JAndrassy/Regulator/img/GALLERY.MD

# Project history in images

## 2017

Kemo modules and Arduino Uno WiFi Developer Edition

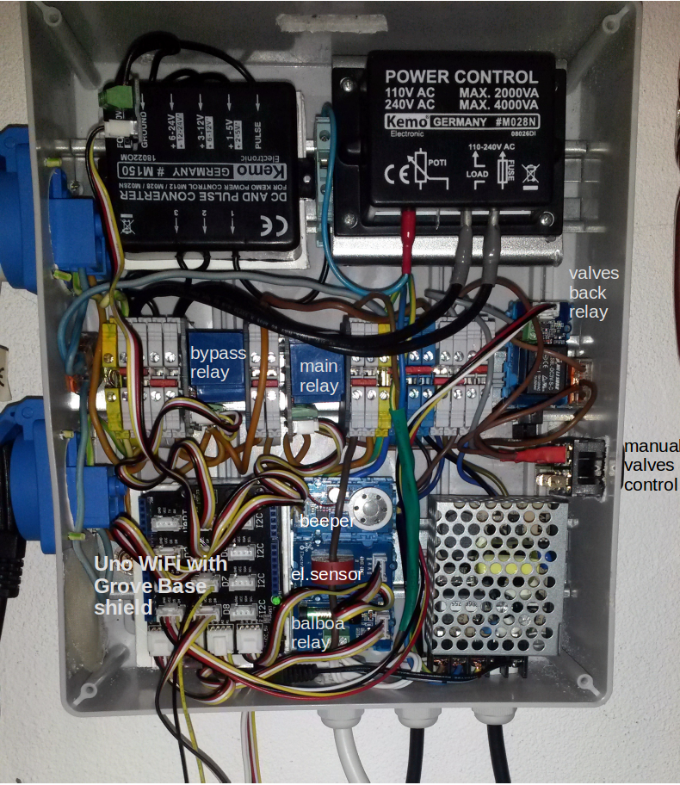
[picture p4: img/regulator-labeled.png]


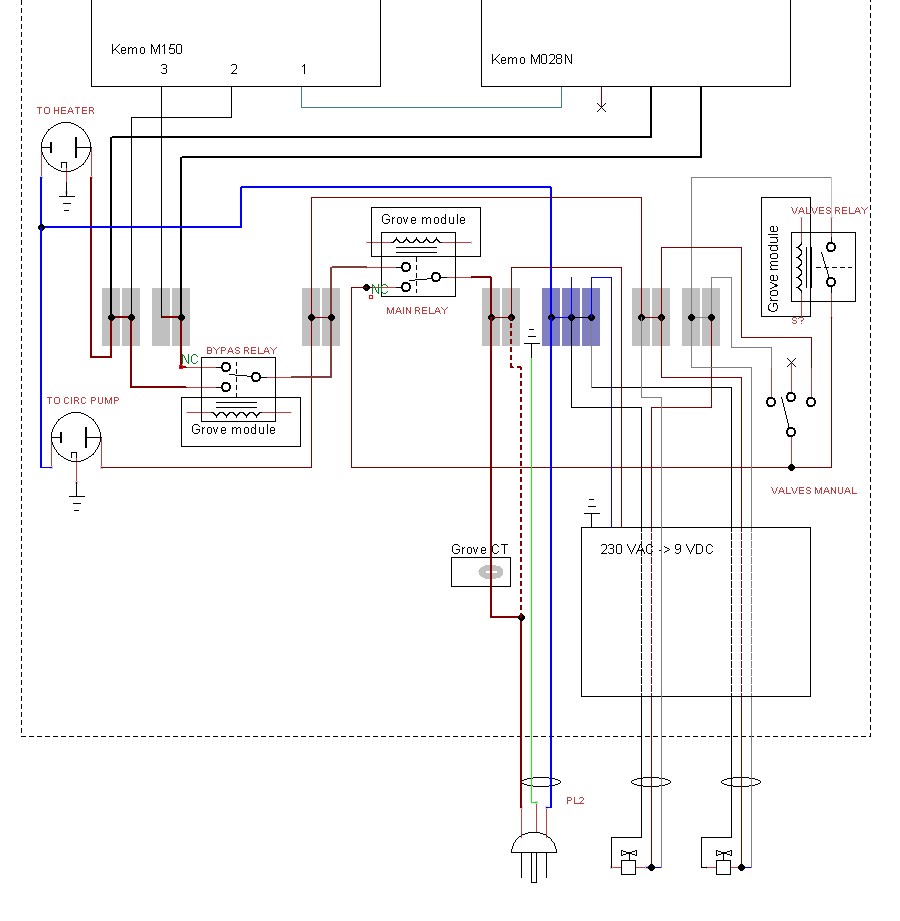
[picture p5: img/schemaAC.png]


## 2018-05

With Wemos D1 R2, MOSFET and I2C ADC module.

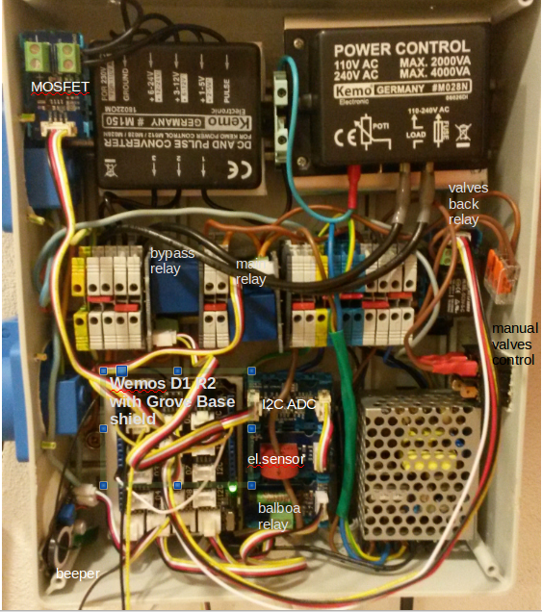
[picture p6: img/regulator-d1-labeled.png]




## 2018-09

Crowduino M0-SD with Ethernet shield and experiments with the ENC28J60 module.

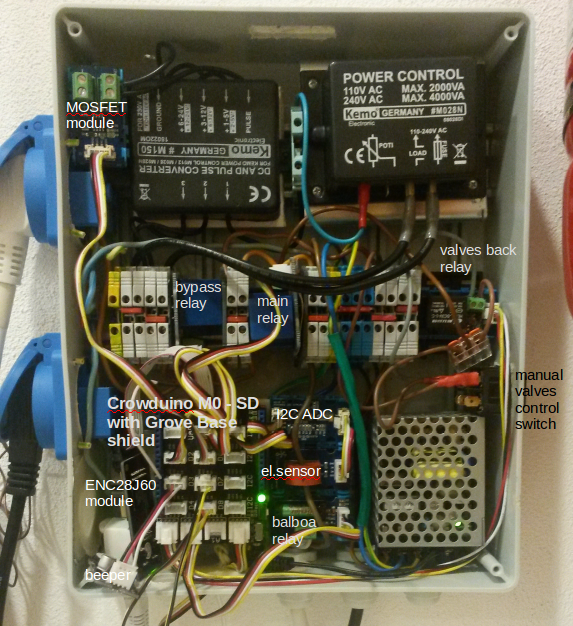
[picture p7: img/regulator-m0-labeled.png]


## 2019

Kemo modules replaced with Triac/ZC module.

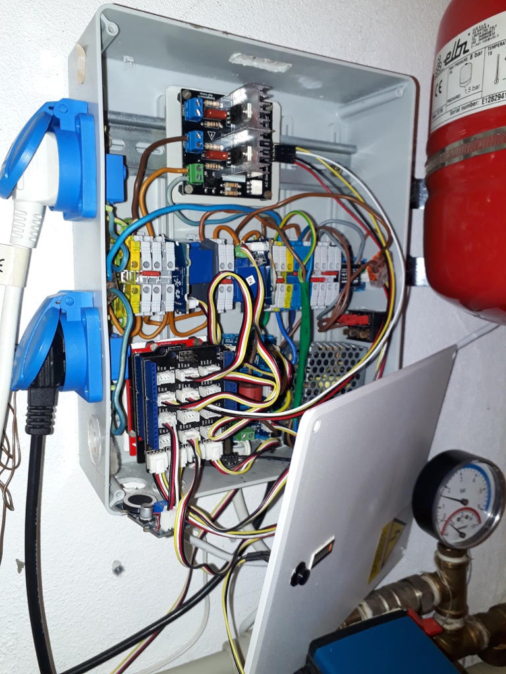
[picture p8: img/regulator-w-dimmer.jpg]


# 2020 - 2021

AVR ATmega1284p board with Ethernet Shield, CT replaced with ACS712 and the power adapter replaced.





ENC28J60 with my EthernetENC library. Circ. pump relay experiment.



# 2022

Single Triac module with a large heatsink.



End of circ. pump experiment. SSR relays.



Nano 33 IoT experiment with a temporary voltage divider on a mini breadboard.

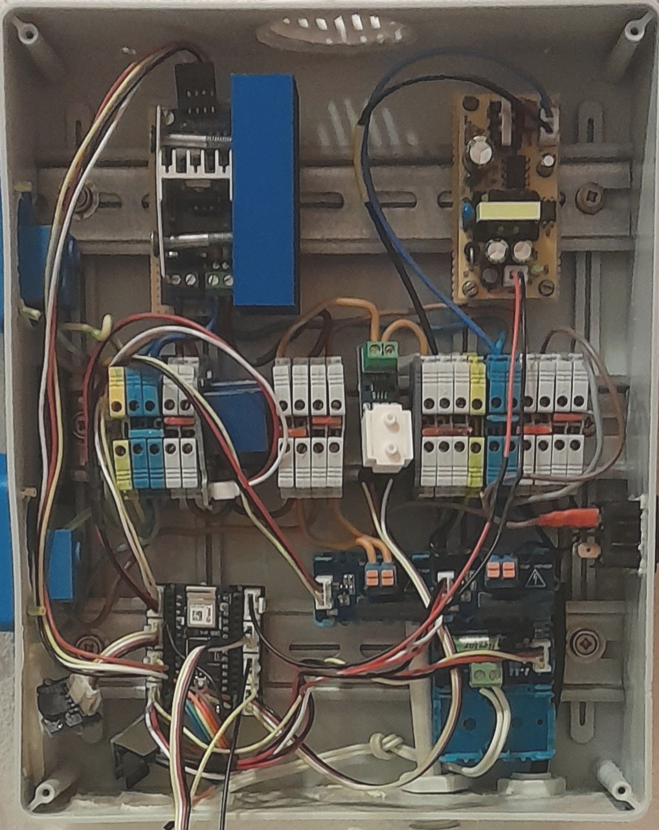
[picture p9: img/regulator-nanoiot.jpg]


MKR Connector Carrier experiment with a MKR1000 WiFi.

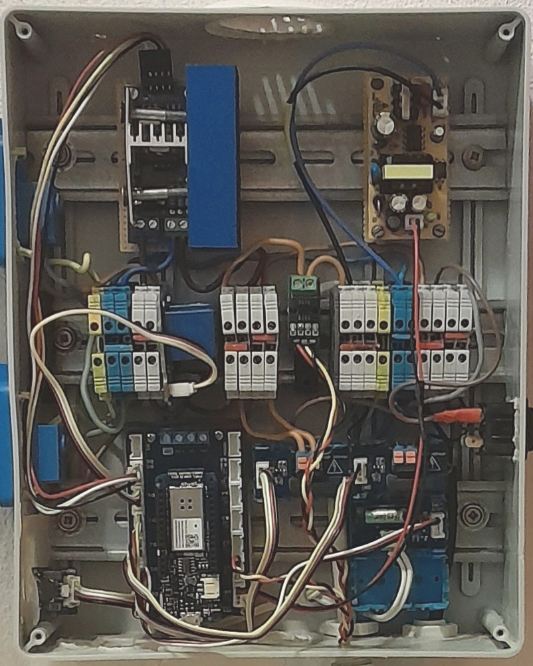
[picture p10: img/regulator-mkr.jpg]
