JAndrassy/Regulator/(list of files, drawings)

Other design files:
img/rlk.dsn
