JAndrassy/Regulator/Regulator/Events.ino

const unsigned long EVENTS_SAVE_INTERVAL_SEC = 10 * 60; // sec 10 min
const char* eventLongLabels[EVENTS_SIZE] = {"Events", "Reset", "Watchdog", "Network", "Pump", "Modbus",
    "Overheated", "Manual run", "Valves back", "PowerPilot plan", "Stat.save"};
const char* blynkCode[EVENTS_SIZE] = {"events", "reset", "watchdog", "network", "pump", "modbus",
    "overheated", "manual_run", "valves_back", "powerpilot_plan", "stat_save"};
const unsigned short eventIsError = bit(WATCHDOG_EVENT) | bit(NETWORK_EVENT) | bit(PUMP_EVENT) | bit(MODBUS_EVENT);

#ifdef NO_EEPROM
const char* EVENTS_FILENAME = "EVENTS.DAT";
#else
const int EVENTS_EEPROM_ADDR = 0;
#endif

struct EventStruct {
  unsigned long timestamp;
  int value1;
  int value2;
  byte count;
};

const unsigned long MIN_VALID_TIME = SECS_YR_2000 + SECS_PER_YEAR;

unsigned long eventsTimer = 0;
EventStruct events[EVENTS_SIZE];

void eventsSetup() {
#ifdef NO_EEPROM
#ifdef FS
  if (!FS.exists(EVENTS_FILENAME)) {
    events[EVENTS_SAVE_EVENT].timestamp = 0xFFFFFFFF;
  } else {
    File file = FS.open(EVENTS_FILENAME, FILE_READ);
    file.readBytes((char*) events, sizeof(events));
    file.close();
  }
#endif
#else
  EEPROM.get(EVENTS_EEPROM_ADDR, events);
#endif
  eventsTimer = events[EVENTS_SAVE_EVENT].timestamp;
  if (eventsTimer == 0xFFFFFFFF) { // empty EEPROM
    for (unsigned int i = 0; i < EVENTS_SIZE; i++) {
      events[i].timestamp = 0;
      events[i].count = 0;
    }
    eventsTimer = 0;
  } else {
    unsigned long t = events[POWERPILOT_PLAN_EVENT].timestamp;
    if (day(t) == day() && month(t) == month() && year(t) == year()) {
      powerPilotPlan = events[POWERPILOT_PLAN_EVENT].value1; // to restore the value after reset
    }
  }
  short hours = (now() - events[RESTART_EVENT].timestamp) / (60 * 60);
  if (hours) {
    eventsWrite(RESTART_EVENT, hours, events[RESTART_EVENT].value1);
  } else {
    eventsWrite(RESTART_EVENT, events[RESTART_EVENT].value1, events[RESTART_EVENT].value2);
  }
}

void eventsLoop() {
  if (now() > MIN_VALID_TIME) {
    if (events[RESTART_EVENT].timestamp < MIN_VALID_TIME) { // time was not set in setup()
      unsigned long t = now() - (millis() / 1000);
      events[RESTART_EVENT].timestamp = t;
      if (eventsTimer > t || eventsTimer < MIN_VALID_TIME) {
        eventsTimer = t;
      }
    }
    if (now() - eventsTimer > EVENTS_SAVE_INTERVAL_SEC) {
      eventsSave();
    }
  }
}

void eventsWrite(int newEvent, int value1, int value2) {
  EventStruct& e = events[newEvent];
  unsigned long last = e.timestamp;
  if (now() > MIN_VALID_TIME && last > MIN_VALID_TIME  //
      && (year(last) != year() || month(last) != month() || day(last) != day())) {
    e.count = 0; // start counting with first event of this type today
  }
  e.timestamp = now();
  e.value1 = value1;
  e.value2 = value2;
  e.count++;
  if (newEvent != EVENTS_SAVE_EVENT && newEvent != STATS_SAVE_EVENT) {
    char buff[64];
    sprintf_P(buff, PSTR("%s %d %d"), eventLongLabels[newEvent], events[newEvent].value1, events[newEvent].value2);
    Blynk.logEvent(blynkCode[newEvent], buff);
#ifdef FS
    log(buff);
#endif
  }
}

boolean eventsSaved() {
  for (unsigned int i = 0; i < EVENTS_SIZE; i++) {
    if (events[i].timestamp > eventsTimer)
      return false;
  }
  return true;
}

void eventsSave() {
  if (eventsSaved())
    return;
  eventsWrite(EVENTS_SAVE_EVENT, 0, 0);
#ifdef NO_EEPROM
#ifdef FS
  File file = FS.open(EVENTS_FILENAME, FILE_NEW);
  if (file) {
    file.write((byte*) events, sizeof(events));
    file.close();
  }
#endif
#else
  EEPROM.put(EVENTS_EEPROM_ADDR, events);
#endif
  eventsTimer = events[EVENTS_SAVE_EVENT].timestamp;
  msg.print(F(" events_saved"));
}

byte eventsRealCount(bool errorsOnly) {
  byte ec = 0;
  unsigned long midnight = previousMidnight(now());
  for (byte  i = RESTART_EVENT; i < STATS_SAVE_EVENT; i++) {
    if (events[i].timestamp > midnight && (!errorsOnly || (eventIsError & bit(i)))) {
      ec += events[i].count;
    }
  }
  return ec;
}

void eventsPrint(Print& stream) {
  byte map[EVENTS_SIZE];
  for (unsigned int i = 0; i < EVENTS_SIZE; i++) {
    map[i] = i;
  }
  qsort(map, EVENTS_SIZE, 1, eventsCompare);
  stream.println(F("Event name     |timestamp          |v1   |v2   |cnt|"));
  for (unsigned int i = 0; i < EVENTS_SIZE; i++) {
    EventStruct& event = events[map[i]];
    if (i > 0) {
      if (event.timestamp == 0)
        continue;
    }
    eventsPrint(stream, map[i]);
    stream.println();
  }
}

void eventsPrint(Print& s, int ix) {
  unsigned long t = events[ix].timestamp;
  char buff[64];
  sprintf_P(buff, PSTR("%-15s|%d-%02d-%02d %02d:%02d:%02d|% 5d|% 5d|% 3u|"), eventLongLabels[ix],
      year(t), month(t), day(t), hour(t), minute(t), second(t),
      events[ix].value1, events[ix].value2, events[ix].count);
  s.print(buff);
}

void eventsPrintJson(FormattedPrint& stream) {
  stream.print(F("{\"e\":["));
  for (unsigned int i = 0; i < EVENTS_SIZE; i++) {
    EventStruct& event = events[i];
    if (i > 0) {
      if (event.timestamp == 0)
        continue;
      stream.print(",");
    }
    eventsPrintJson(stream, i);
  }
  stream.printf(F("],\"s\":%d}"), eventsSaved());
}

void eventsPrintJson(FormattedPrint& stream, int ix) {
  stream.printf(F("{\"i\":%i,\"t\":%lu,\"v1\":%d,\"v2\":%d,\"c\":%u}"), ix, events[ix].timestamp, events[ix].value1, events[ix].value2, events[ix].count);
}

int eventsCompare(const void * elem1, const void * elem2) {
  return (events[*((byte*) elem2)].timestamp < events[*((byte*) elem1)].timestamp) ? -1 : 1;
}
