JAndrassy/Regulator/Regulator/ManualRun.ino

const unsigned long MANUAL_RUN_MILLIS = 90 * 60000; // 1.5 h

unsigned long manualRunStart = 0;

void manualRunLoop() {
  if (manualRunRequest) { // from UI
    if (manualRunStart != 0) {
      manualRunRequest = false;
      heatingPower = 0;
      manualRunStart = 0; // stop
      state = RegulatorState::MONITORING;
    } else if (turnMainRelayOn()) {
      manualRunRequest = false;
      manualRunStart = loopStartMillis;
      waitZeroCrossing();
      digitalWrite(BYPASS_RELAY_PIN, HIGH);
      bypassRelayOn = true;
      heatingPower = BYPASS_POWER;
      state = RegulatorState::MANUAL_RUN;
      eventsWrite(MANUAL_RUN_EVENT, 0, 0);
    }
  }
  if (state == RegulatorState::MANUAL_RUN && (loopStartMillis - manualRunStart) > MANUAL_RUN_MILLIS) {
    manualRunStart = 0;
    state = RegulatorState::MONITORING;
  }
}

byte manualRunMinutesLeft() {
  return (!manualRunStart) ? 0 : ((MANUAL_RUN_MILLIS - (loopStartMillis - manualRunStart)) / 60000) + 1;
}
