JAndrassy/Regulator/util/RegulatorDev/gbs-d1r2.h

// Grove Base Shield labels mapping for Wemos D1 R2
#define GBS_RX_io1_RX0 RX
#define GBS_D2_io16 D0
#define GBS_D3_io5_I2C_SCL D1
#define GBS_D4_io4_I2C_SCA D2
#define GBS_D5_io0_PULLUP D3
#define GBS_D6_io2_PULLUP D4
#define GBS_D7_io14 D5
#define GBS_D8_io12 D6
#define GBS_D9_io13 D7
#define GBS_A0_A0_3V3 A0
#define GBS_A2_io15_PULLDOWN D8 // with jumper wire on GBS headers 10->A2
#define GBS_A3_io3_TX0 TX // with jumper wire on GBS headers 1->A3
