JAndrassy/Regulator/(commit log)

2018-04-18 Regulator.ino - patch for Blynk in Arduino IDE
2018-04-27 PowerPilot - 6 mapping points
2018-04-28 Blynk.ino - lower memory config and MR button initial state
2018-05-13 global variable for current hour
2018-05-21 clear state transitions (to monitor Symo battery discharge while 'manual run')
2018-05-21 Modbus - 16 bit type 'short' for register values (esp8266 compatibility)
    [Modbus.ino]
2018-06-11 PowerPilot and ElSens with esp8266
2018-06-11 WebServer at http://regulator.local/
2018-06-24 Beeper - beeps with pwm for esp8266
2018-06-24 ValvesBack is back without temp.sens. for now
2018-06-24 StatusLed.ino - added as simple 1 pin alternative to LedBar
2018-07-01 ElSens with Grove I2C ADC, TEMPSENS is A0 and VALVES_RELAY is on TX
2018-07-15 PowerPilot - pwm value calculated with function
2018-08-08 adjustments and fixes 2
    [Beeper.ino, CsvLog.ino, ElSens.ino, Events.ino, PowerPilot.ino, Regulator.ino, ValvesBack.ino, Watchdog.ino]
2018-08-09 Beeper - tone() is fixed in esp8266 2.4.2
    [Beeper.ino]
2018-08-24 ARDUINO_ARCH_SAMD support (M0, Zero, MKR)
    and removed Ariadne support
2018-11-01 adjustments and fixes 3
    [Blynk.ino, CsvLog.ino, ElSens.ino, Events.ino, ManualRun.ino, Modbus.ino, PowerPilot.ino, Regulator.ino]
2019-01-13 ArduinoOTA library and UIPEthernet used
    WebServer fix
    [Regulator.ino, WebServer.ino, consts.h]
2019-05-05 adjustments and fixes 4
    [ElSens.ino, Events.ino, Modbus.ino, PowerPilot.ino, Regulator.ino, Stats.ino, ValvesBack.ino, Watchdog.ino]
2019-05-05 include pump consumption in elsensPower
2019-05-12 in bypass mode ignore short PV shadows or small concurrent consumption
    [Modbus.ino, PowerPilot.ino, Regulator.ino]
2019-07-07 adjustments and fixes 5
    [ElSens.ino, Events.ino, Modbus.ino, PowerPilot.ino, Regulator.ino, Stats.ino, ValvesBack.ino, Watchdog.ino]
2019-09-22 PowerPilot - Triac dimmer module support and related changes
2019-10-20 ElSens - ACS712 el. sensor on 5 V ATmega 'analog' pin
    [RegulatorDev.ods, dimmer-dev.ods, elsens2power.ods, power2period.ods]
2020-01-12 adjustments and fixes 6
    [ElSens.ino, Events.ino, Modbus.ino, Regulator.ino]
2020-01-12 TriacLib - generalized for all Arduino mapped TCC0 and TCC1 pins
2020-04-18 adjustments and fixes 7
    [CsvLog.ino, ElSens.ino, Events.ino, Modbus.ino, PowerPilot.ino, Regulator.ino, Stats.ino, Telnet.ino]
2020-04-18 switching relays on zero crossing
2020-04-18 MKR on MKR Connector Carrier support
2020-04-18 arduino_secrets.h by the book
2020-06-15 adjustments and fixes 8
    [ManualRun.ino, PowerPilot.ino, Telnet.ino, TriacLib.h]
2020-06-17 UI buttons improvements and new manual Balboa pause button
2020-07-05 powerPilotPlan for regulation strategy selected by user
2020-08-27 adjustments and fixes 9
    [Blynk.ino, Modbus.ino, PowerPilot.ino, Regulator.ino, RegulatorDev.ino, Stats.ino, Telnet.ino, consts.h]
2020-09-21 power supply change - ElSens and README update + snubber
2020-09-28 board types - nRF removed, M0 changed to Zero
2020-10-15 PowerPilot - Triac only. PWM code removed
2020-10-18 ValvesBack - main heating temperature requested from EMS-ESP Arduino
2021-02-27 adjustments and fixes 10
    [Blynk.ino, ElSens.ino, Modbus.ino, Regulator.ino, RegulatorDev.ino, StatusLed.ino, TriacLib.h, ValvesBack.ino]
2021-03-06 circ.pump relay added
    [rlk.dsn]
2021-04-03 control of external heater over Wemo Inside
    and consumption to Blynk table
2021-09-25 adjustments and fixes 11
    [Blynk.ino, ConsumptionMeter.ino, Events.ino, Modbus.ino, PowerPilot.ino, Regulator.ino, Stats.ino, Telnet.ino]
2021-09-30 turn valves before start heating - OPENING_VALVES state
2022-05-05 adjustments and fixes 12
    [dimmer-dev.ods, power2period.ods]
2022-05-15 circ.pump relay and OPENING_VALVES state removed
    [rlk.dsn]
2022-05-19 buzzer instead of speaker with amplifier module
    [Beeper.ino, Watchdog.ino]
2022-07-18 adjustments and fixes 14
    [Beeper.ino, ElSens.ino, PowerPilot.ino, Regulator.ino, RegulatorDev.ino, TriacLib.h, Watchdog.ino, consts.h]
2022-08-20 Arduino Nano 33 IoT
2023-02-11 adjustments and fixes 15
    [CsvLog.ino, ElSens.ino, Events.ino, Modbus.ino, PowerPilot.ino, Regulator.ino, RegulatorDev.ino, Watchdog.ino]
2023-02-12 external heater control removed
2023-03-02 reordering of PowerPilot plans enum
    and plan "heating disabled" is default
2023-04-21 ValvesBack.ino - wait time depends on consumed power
2023-04-23 BattSet - send for manually started heating
2023-08-29 adjustments and fixes 13
    [Blynk.ino, Modbus.ino, PowerPilot.ino, Watchdog.ino]
2024-02-03 adjustments and fixes 16
    [CsvLog.ino, Events.ino, Modbus.ino, Stats.ino, WebServer.ino]
